y0sshi/RISC-V/boards/zybo_z720/vitis/README.md

# Zybo Z7-20 real-HW bring-up (Vitis / boot side)

Offline (no-board) preparation for booting the RISC-V SoC bitstream on real Zybo
Z7-20 hardware. The Vivado bitstream side is in `../vivado/`; this directory holds
the PS-side boot artifacts (XSA -> FSBL -> BOOT.bin) and the JTAG bring-up script.

All Xilinx tools must run from **PowerShell**, not Bash/MSYS (its path translation
crashes Vivado synth and the Vitis server). Find the tools via `$env:XILINX_VIVADO` /
`$env:XILINX_VITIS` (or PATH after `settings64.bat`); examples below run from the repo
root, where `$PWD\...` gives Vivado the absolute `-source` path it needs.

**One-shot (cross-platform):** `python boards/zybo_z720/build_all.py` (Windows or Linux,
stdlib only) runs `bit -> fsbl -> bootbin` (use `--stage xsa fsbl bootbin` to reuse an
existing impl).  Retarget the PL clock first with `python ..\set_pl_freq.py <MHz>`.  The
bash/docker side (firmware, sim, tests) is the top-level `make` -- run `make help` at the repo root.

## Clock / UART facts baked into the design (read first)

- PL clock `FCLK_CLK0` = **25 MHz** (`build_zybo.tcl` `PL_FREQMHZ=25`).
- `rv_soc` `MTIME_DIV=1` => CLINT `mtime` ticks at **25 MHz** on hardware.
- The 16550 bit period is `divisor*16` PL clocks; the 8250 driver programs
  `divisor = clock-frequency/(16*baud)`, so `actual_baud = PL/(divisor*16) =
  25e6*baud/clock-frequency`.

Therefore the **real-HW device tree** (`docs/opensbi/rv_soc_hw.dts`,
`tests/linux/rv_soc_linux_hw.dts`) differs from the sim DTS in three constants:

| DT property | sim (`*_lo.dts`) | real HW (`*_hw.dts`) | why |
|---|---|---|---|
| `timebase-frequency` | 1000000 | **25000000** | mtime really runs at 25 MHz (sim slows it via `BOOT_MTIME_DIV=64`); wrong value = 25x time error + HZ-tick livelock risk |
| serial `clock-frequency` | 1843200 | **25000000** | must equal the PL clock or the baud divisor is wrong |
| serial `current-speed` | 115200 | **57600** | 25 MHz can't make a clean 115200 (+/-4%); 57600 -> divisor 27 -> 57870 baud = +0.47% |

Use a **57600 8N1** terminal on hardware.

## prep-A/B/C (done offline)

- **prep-A** real-HW DTS: `docs/opensbi/rv_soc_hw.dts`, `tests/linux/rv_soc_linux_hw.dts`.
- **prep-B** export XSA from the built impl (no re-impl):
  ```
  & "$env:XILINX_VIVADO\bin\vivado.bat" -mode batch `
      -source $PWD\boards\zybo_z720\vivado\export_xsa.tcl `
      *> $PWD\boards\zybo_z720\vivado\export_xsa.log 2>&1
  ```
  -> `../vivado/rv_riscv_zybo/rv_riscv_zybo.xsa` (ps7_init + bitstream). The full
  `build_zybo.tcl bit` flow now also emits the XSA automatically.
- **prep-C** FSBL + BOOT.bin:
  ```
  & "$env:XILINX_VITIS\bin\vitis.bat" -s `
      $PWD\boards\zybo_z720\vitis\fsbl.py *> $PWD\boards\zybo_z720\vitis\fsbl.log 2>&1
  python make_bootbin.py --firmware <fw_payload_hw.bin>   # or .\make_bootbin.ps1 -Firmware ... ; default = sim fw_payload_lo.bin
  ```
  - FSBL is auto-generated by the standalone platform build ->
    `ws/zybo_plat/export/zybo_plat/sw/boot/fsbl.elf` (32-bit ARM, ps7_init).
  - `make_bootbin.ps1` writes `boot.gen.bif` (firmware **before** bitstream, raw
    `.bin` with `[load=0x00200000]` and no exec addr) and runs bootgen. Verified
    layout: FSBL(exec OCM) -> firmware@0x200000 (data, no A9 handoff) -> bitstream
    last, so the RISC-V core leaves reset with firmware already resident in DDR.

## prep-D/E (done offline) -- ready for the board

- **prep-E DONE** real-HW OpenSBI hello firmware is built and BOOT.bin is staged
  with it:
  - `tests/opensbi/work/fw_payload_hw.{elf,bin}` (entry 0x200000, 25 MHz/57600 DTB),
  - `BOOT.bin` regenerated via `make_bootbin.ps1 -Firmware ...fw_payload_hw.bin`.
  - Rebuild recipe (if the DTS changes):
    ```
    docker run --rm -v "E:/work/git/RISC-V.git:/workspace" -w /workspace/tests/opensbi \
      riscof_run:latest bash -c \
      "FW_BASE=0x00200000 DTS=/workspace/docs/opensbi/rv_soc_hw.dts OUT=fw_payload_hw bash build.sh"
    cp tests/opensbi/work/opensbi/build/platform/generic/firmware/fw_payload.elf \
       tests/opensbi/work/fw_payload_hw.elf
    .\make_bootbin.ps1 -Firmware ...\fw_payload_hw.bin
    ```
  - Linux later: `tests/linux/build.sh` with `DTS=.../rv_soc_linux_hw.dts
    OUT=fw_payload_linux_hw` (CRLF-strip per CLAUDE.md); swap the elf in
    `bringup_jtag.tcl`.
- **prep-D DONE** JTAG bring-up script `bringup_jtag.tcl` (XSDB debug flow, which IS
  available here -- only the classic IDE project flow is not). It `connect`s,
  selects the A9, runs `ps7_init`/`ps7_post_config`, `dow`s `fw_payload_hw.elf` to
  0x200000, then `fpga`-configures the PL so the RISC-V core boots from 0x200000.
  `ps7_init.tcl` is extracted from the XSA (gitignored; re-extract with
  `python -c "import zipfile; open('ps7_init.tcl','wb').write(zipfile.ZipFile(r'../vivado/rv_riscv_zybo/rv_riscv_zybo.xsa').read('ps7_init.tcl'))"`).

## On the board (P1 -- run these)

1. Power the Zybo, set JTAG boot mode (or insert the SD with `BOOT.bin` for SD boot).
2. Wire a 3.3 V USB-UART to **Pmod JC**: FPGA TX=**V15** -> adapter RX,
   FPGA RX=**W15** <- adapter TX, common GND. Open the terminal at **57600 8N1**.
3. JTAG path (recommended):
   ```
   & "$env:XILINX_VITIS\bin\xsct.bat" `
       $PWD\boards\zybo_z720\vitis\bringup_jtag.tcl
   ```
   Expect the OpenSBI banner + `PAYLOAD: hello` on the UART.
4. SD path (alternative): copy `BOOT.bin` to a FAT32 SD card, set SD boot mode,
   power-cycle.

## Artifacts (all gitignored)

- `ws/` Vitis workspace + FSBL, `../vivado/rv_riscv_zybo/rv_riscv_zybo.xsa`,
  `BOOT.bin`, `boot.gen.bif`, `*.log`.
