y0sshi/RISC-V/(commit log)

2026-06-04 UART 16550
2026-06-13 timing: cut worst-path fanout with max_fanout hints
2026-06-14 boards: build RV64 FPGA bitstream; fix BD module-ref + OOC XLEN define
    [rv_soc_wrap.v]
2026-06-14 fix: mal_state restart-livelock under ~imem_ready (RTL bug #15)
    The misaligned 2-phase access FSM reset mal_state to idle unconditionally once
    both word accesses finished, even when the instruction could not retire that
    cycle (EX held by ~imem_ready from an in-flight I$ fill / straddle bypass).
    That re-asserted mal_stall and restarted phase 0 -> permanent stall_if -> no
    interrupts -> livelock. Same restart class as amo_state / muldiv_done(#14) /
    fpu_done, but mal was the one unguarded FSM. Latent since before afe5f4a; the
    C-2a/C-2c multicycle work shifted pipeline timing enough to expose it (C-2b
    BRAM only changed where the kernel derailed).
    [rv_core.sv]
2026-06-14 fix: misaligned LOAD phase-0 word lost to flush_ex_mem on younger-instr trap (RTL bug #16)
    A misaligned 8-byte LOAD retiring from MEM had its mal FSM reset by the generic
    flush_ex_mem when a timer interrupt was taken on the YOUNGER EX-stage instruction,
    zeroing mal_first_data on its capture cycle (mal_phase1_start) so the load wrote
    back only its phase-1 half. Reset the mal FSM only on the access's own MEM fault
    (mal_squash = mem_trap_enter & ~stall_ex). Strict no-op except preserving the
    phase-0 word. Repro: src/software/boot/mal_load_irq_test.S.
    Regression: mal_load_irq_test PASS (old FAIL), mini-SBI IF=573 data=4 unchanged,
    RV64 117/RV32 88, full Linux LINUX-USERSPACE-OK, #14/#15/atomic/l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
    [rv_core.sv]
2026-06-15 boards: real-HW Zybo BD (PS7 board preset + UART Pmod pins + DDR RST_ADDR)
    Promote the headless Zybo bitstream to a board-bootable config: vendor the
    Digilent Zybo Z7-20 board files, apply the PS7 board preset and externalize
    FIXED_IO/DDR (FIXED_IO critical warnings 100->0), route UART to Pmod JC
    (V15/W15) via zybo_uart.xdc, and set RST_ADDR=0x0020_0000 so the firmware
    sits in the HP0-mapped PS DDR window. Timing closes at 25 MHz (WNS +0.377ns,
    0 failing EP). Sim unchanged (rv_soc default RST_ADDR=0x8000_0000).
    [muldiv_split_meas.sv, rv_soc_wrap.v, tb_rv_boot_soc.sv]
2026-06-16 boards: real-HW bring-up prep (real-HW DTS + XSA export + FSBL/BOOT.bin)
2026-06-16 boards: real-HW firmware (0x200000 DTS) + JTAG bring-up script
2026-06-16 build: unify entry points (top-level Makefile + FPGA build_all.ps1)
    Organize scattered commands into two families (hard constraint: Vivado/Vitis
    need PowerShell, so "all make" is impossible):
    - top-level Makefile: thin dispatcher for the bash/docker flows (deps/fw-*/
    boot-*/compliance/riscof/sim-* delegation). Quote $(MAKE) -- GnuWin32 make's
    spaced "(x86)" path breaks under MSYS /bin/sh otherwise.
    - boards/zybo_z720/build_all.ps1: one-shot bit -> fsbl -> bootbin.
    Dependency policy: keep riscv-tests/riscv-arch-test as submodules; OpenSBI/Linux/
    arch-test-suite stay pinned clones/tarballs (CRLF + size + docker-built), with
    `make deps` pinning OpenSBI v1.2.
2026-06-18 fix(icache): serve RVC line-crossing window as a 2-line hit, drop S_BYPASS
    The straddle (line-crossing) fetch window was served by a multi-cycle
    uncached bypass. When a branch/redirect targeted a straddle address whose
    second line was not yet cached, the bypass exposed a fetch/redirect squash
    race that livelocked OpenSBI (stuck at fdt_address_cells entry, 314 chars)
    and Linux. Replace the bypass with a 2-line cache supply: a second
    registered read port (line_q2, set idx+1) gives a 1-cycle hit when both
    adjacent lines are cached; a cold straddle fills the missing line(s) via
    the normal S_FILL/S_FILL2 path then hits. No uncached path remains, so
    every access is an aligned line burst (also fixe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
    [rv_icache.sv, tb_rv_icache.sv]
2026-06-18 refactor(boards): cross-platform Python FPGA build (build_all.py/make_bootbin.py)
2026-06-18 fix(soc): honor D$ wait during an instruction-fetch PTW (AMO write-loss)
    rv_soc's `core_dmem_wait = ptw_req ? 0 : dc_c_wait` blinded the core to an
    in-flight D-cache access for ANY ptw_req -- including an instruction-fetch
    page-table walk (ptw_for_if=1) that is independent of the held data access.
    When an amoadd.w's read phase took a D$ miss (multi-cycle line fill) and a
    concurrent IF-PTW fired during the fill, the mask dropped dmem_wait to 0, so
    amo_state advanced to its WRITE phase mid-fill (rv_core.sv:923); the AMO then
    retired at the S_RELOOKUP cycle (c_wait drops) before S_LOOKUP could latch the
    write -> the AMO write was LOST. atomic_dec_and_test on nl_table_users then
    left the counter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
    [rv_axi_dualport_mem_bfm.sv, rv_cpu.sv, rv_mmu.sv, rv_soc.sv, tb_rv_boot_soc.sv]
2026-06-19 perf(core/dcache): register D$ tag behind a per-access strobe + fix SRET-handoff deadlock (50MHz step 1)
    Two coupled changes toward raising the core from 25 to 50 MHz. The critical
    path is a single combinational chain
    ex_mem_alu_result -> data TLB -> D$ tag -> dmem_wait -> stall_if -> fetch -> I$
    (real ~38.5ns @25MHz, needs <=20ns).
    1) Register the D$ tag lookup so it no longer reaches c_wait in one cycle.
    A naive in-place 2-phase oscillated c_wait every cycle on a hit HELD in MEM
    by an unrelated stall -- the simple bus is level-req (no per-access strobe),
    so the D$ cannot tell a NEW access from a completed-but-held one; that
    corrupted atomics under full Linux. Instead rv_cor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
    [rv_core.sv, rv_cpu.sv, rv_dcache.sv, rv_soc.sv, tb_rv_boot_soc.sv, tb_rv_dcache.sv]
2026-06-20 perf(core/mmu): register the data-TLB MEM-port lookup off the stall_if path (50MHz step 2)
    Pass the per-access strobe into rv_mmu's MEM port and drive
    mem_pa/mem_req_out/mem_fault/mem_stall from a registered TLB lookup
    (vm_data-gated; bare/M-mode passthrough no-op). Removes the data TLB
    from the ex_mem_alu_result -> ... -> stall_if critical path (impl
    worst-path moves to the D$-load -> FPU-forward chain; WNS 0.370->1.130
    @25MHz). Fixes three variable-latency bugs the registration exposed:
    eviction-spurious-PTW store-loss (gate PTW launch by ~mem_reg_ready),
    stale mt_valid (clear on !mem_req), and the registered-mem_fault
    commit-gate deadlock (gate the trap redirect by ~stall_ex, same as the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
    [rv_core.sv, rv_cpu.sv, rv_mmu.sv, tb_rv_mmu.sv]
2026-06-20 perf(core/fetch): pipeline the fetch (decoupled FIFO + registered redirect) to take
    the data stall and the trap/branch redirect off the imem_addr -> IF-TLB -> I$ path
    (50MHz step 4, approach B)
    Decouple the fetch engine from decode with a 4-deep fetch FIFO (step 1) so the data
    stall reaches imem_addr only through the registered ff_count occupancy, and register
    the redirect steer (step 2) so the data-dependent combinational redir_req no longer
    fans out to imem_addr. Together imem_addr becomes fully register/I$-local driven,
    removing the ex_mem_alu_result -> dmem_wait/irq -> redir_req -> imem_addr -> IF-TLB
    -> I$ worst path. Cost: +4.5% boot cycles (FIFO) + a +1-cycle taken-redirect
    penalty;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
    [rv_core.sv]
2026-06-21 Fix/Refactor: Bump CPU clock frequency from 25MHz to 30MHz
    [rv_core.sv, rv_fpu.sv, rv_muldiv.sv, tb_rv_fpu.sv, tb_rv_mext.sv]
2026-06-21 perf(fpga): bump CPU clock 30->40MHz (RTL unchanged; fetch loop is not the binding path)
    Real-impl measurement under a tight clock constraint overturns the
    sessions-14..16 conclusion that the IF fetch-translation loop is the 50MHz
    binding path and that a decoupled block-fetch rewrite (case A) is the only
    way to 20ns. That conclusion was an artifact of the slack 33ns constraint:
    Vivado relaxes placement once timing is met, inflating the fetch loop to
    ~29.5ns and making it look like the binding path.
    Probing the synth checkpoint at a 20ns constraint (build_physopt.tcl, both
    default and aggressive strategies) shows the placer/router pushes the fetch
    loop under ~21ns, and the new binding path be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
2026-06-22 perf(core/fpu): register the FP-adder operands to break the EX-forward->sum_q path (50MHz step 7)
    The post-step6 50MHz binding was the FP adder sum_q stage-0
    (ex_mem_rd_addr -> FP forward select -> fpld load forward -> adder
    operand -> align/exp-subtract -> mantissa-add CARRY4 -> sum_q, ~21.4ns
    @20ns probe). Mirror step 5 (misc): the four adders now read REGISTERED
    operands instead of the live EX forward mux output -- u_add fa_s_q/fb_s_q,
    u_add_d fa_q/fb_q (existing), u_fma_add fc_s_q, u_fma_add_d fc_q (new
    free-running fc register) -- cutting the forward-mux + fpld routing off
    the front of the adder stage-0 cloud.
    Latency-neutral (COMB_LAT unchanged, rv_core unchanged): FADD lands at
    T+2,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
    [rv_fpu.sv]
2026-06-25 fix(icache): serve a completed fill before the resume-prime advances addr_q (step8 fetch-skip)
    step8's FTQ presents the next address while the current word is still being
    filled. If that next address takes an IF-TLB-miss PTW, the MMU withdraws
    c_req mid-fill (req_q drops), so the completed fill is never served; the
    resume-prime then overwrites addr_q with the next address, SKIPPING the
    filled word and mis-tagging the next word with the skipped PC (aligner
    PC/data desync) -> wrong decode -> NULL-deref in full Linux NET=y (~65M cyc).
    Add a fill_unserved latch (set on S_FILL m_done, cleared on c_ready) that
    gates the resume-prime so a completed-but-unserved fill is served first.
    No EXTRA-2 rein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
    [rv_core.sv, rv_cpu.sv, rv_icache.sv, tb_rv_axi_core.sv, tb_rv_axi_ifetch.sv, tb_rv_boot_soc.sv]
2026-06-25 perf(fpu): pipeline rv_fpu_misc_d into 2 stages to break the FCVT D-stage path (50MHz step 9)
    The default-strategy 50MHz binding was the FCVT.D.W / FCVT.W.D second-stage
    combinational tail in rv_fpu_misc_d (operand reg -> compute -> result reg, one
    ~20ns arc, route ~66%). Split it with one internal free-running register: stage 1
    does the FCVT.D.W normalize/shift, the cheap ops, the FCVT.W.D special-case
    detect, and FCVT.S.D/D.S; stage 2 does FCVT.D.W rounding, the FCVT.W.D in-range
    shift+round+sign, and the output mux. The two heavy barrel shifts land in
    separate stages.
    Latency-neutral: COMB_LAT stays 2. The old misc path had one cycle of capture
    slack (result valid T+2, captured T+3); the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
    [rv_fpu.sv, rv_fpu_misc_d.sv]
2026-06-25 perf(core): interlock integer load->branch + read branch operands from registers (50MHz step 10)
    The default-strategy 50MHz binding path was the load->branch->flush loop:
    D$ BRAM load -> load shaping -> MEM/WB forward -> branch compare -> branch_taken
    -> redirect/flush -> id_ex clock-enable, a single combinational cycle.
    Mirror the existing FP-load fpld technique for the integer branch path:
    - rv_hazard: stall a conditional branch one extra cycle while an integer load it
    depends on is in MEM, so the branch reaches EX only after the load retires and
    its value is captured into id_ex via the regfile write bypass (registered).
    - rv_core: feed u_branch's comparison operands from br_rs*_data,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
    [rv_core.sv, rv_hazard.sv]
2026-06-25 build(fpga): split build_zybo into project/synth/impl/bit stages, drop create_project -force
    Project creation is now its own idempotent stage; synth/impl/bit open the existing
    project and resume (reset-if-stale), so no stage recreates the project and there is
    no -force. impl stops after route_design (reports routed WNS); bit writes the
    bitstream + XSA. build_all.py --stage gains synth/impl/bit/fpga for resuming from an
    intermediate point (e.g. --stage impl bit, or --stage bit alone). Removes the
    stopgap impl_only.tcl.
2026-06-25 perf(fpu): pipeline rv_fpu_add_d into 3 stages for real 50MHz margin (step 11)
    step10 closed default-flow 50MHz at only +0.042 ns, which booted in sim but
    crashed on real silicon (kdevtmpfs/filename_create NULL deref = compute
    corruption from too-thin setup margin; 40MHz ran reliably at +0.172 ns). The
    entire near-worst cluster (top 40 routed paths) was the FPU result network; the
    worst was the double-precision adder, both its align+add (-> sum_q) and its
    normalize/round + output mux (-> ex_mem_fpu_result_f) arcs at ~19.6-19.9 ns.
    Split rv_fpu_add_d from 2 into 3 register stages:
    stage 0: extract/classify/swap/align -> registered aligned operands
    stage 1: 57-bit significand add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
    [rv_fpu.sv, rv_fpu_add_d.sv]
2026-06-27 fix(core): gate FTQ head pop on reload-settle re-serve (step8 fetch skid)
    The redirect-reload settle presents the target for an extra cycle (redir_pend_q
    hold + the ftq[0] reload both drive imem_addr=target), so the I$ serves it once
    more than it is pushed. ftq_pop lacked the ~hb_dup gate that hb_push has, so the
    FTQ head advanced one word ahead of the served/pushed stream; a later full-buffer
    hold release then skipped a served-but-unpushed word, tagging the next word with
    the stale bfpc -> a 4-byte fetch skid. On full Linux this made path_parentat
    execute `sd zero,0(s2)` instead of `sd a5,8(s3)`, leaving parent->dentry NULL ->
    filename_create NULL deref (the Zybo step8 hardware crash; rep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
    [rv_core.sv]
2026-06-27 test(boot-sim): RANDLAT BFM + RANDLAT-immune fetch/mem detectors for step8 debug
    Debug infrastructure that reproduced and root-caused the step8 fetch-skid crash
    (see fix "gate FTQ head pop on reload-settle re-serve"):
    - rv_axi_dualport_mem_bfm: per-channel variable latency (BFM_RANDLAT / BFM_SEED /
    BFM_RAND_SPREAD). Independent LFSR streams de-phase the IF/data/write ports so
    the I$-fill-vs-PTW interleave the bug needs is exercised; deterministic per seed.
    The fixed-latency default phase-locks the ports and hides it.
    - tb_rv_boot_soc detectors (under BOOT_TRACE):
    - [STDROP]/[STCORRUPT]: RANDLAT-immune store/AMO write-to-DRAM matcher -- enqueue
    each committed DRAM write at the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
    [rv_axi_dualport_mem_bfm.sv, tb_rv_boot_soc.sv]
2026-06-29 fix(core): IF page-fault saves the mid-word target PC, not its word
    An instruction page fault captured the WORD-aligned fetch address
    (imem_addr = redirect target & ~3) as the faulting PC. For a redirect
    target that is 2-byte aligned (PC % 4 == 2 -- e.g. a compiled userspace ELF
    entry such as musl's 0x101be), the demand-page handler then returned 2 bytes
    early, to target & ~3 (0x101bc), and executed the low halfword (c.ebreak)
    instead of the entry -> SIGTRAP -> init killed -> kernel panic (exitcode=5).
    The hand-written static init.c (4-byte-aligned entry) and the M/S-mode
    kernel never hit this, so it was masked until a real compiled userspace
    binary (Buildroot busybox/bash) ran.
    Fix: when t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
    [rv_core.sv]
2026-07-02 fix(core): #17 fetch/PTW livelock on demand-paged CALL target IF page fault
    A JAL to an unmapped .text page (musl busybox memset) page-faulted on its
    redirect target; the faulting fetch never raised imem_ready, so the full
    pipeline freeze held the JAL in EX (redir_eff stuck high), the ifpf trap
    could never latch/take, and the MMU walked the dead VA forever (PC frozen,
    zero retires). Add fetch_dead_q to drain in-flight instructions past a
    page-faulted fetch, tighten the ifpf-take gate to all-bubble, and stop the
    dead-IF walk from starving a data PTW / mis-attributing a zombie fault.
    No-op unless an instruction fetch page-faults (fetch_dead_q === 0 in bare/
    M-mode/all compliance). Repro: src/s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
    [rv_core.sv, rv_mmu.sv, tb_rv_boot_soc.sv]
2026-07-02 build(linux): rootfs-in fw + sim boot entry points (fw-linux-rootfs, boot-linux-rootfs)
    Wire the Buildroot rootfs (bash) flow into the top-level Makefile so the
    "build rootfs-in Linux fw -> boot in sim / stage for real HW" path is
    discoverable from `make help` and reachable in a few targets.
    - fw-linux-rootfs / fw-linux-rootfs-hw: thin wrappers that build the
    Buildroot rootfs then wrap it into the Linux fw_payload. The
    ROOTFS=buildroot target-specific variable is inherited by the
    rootfs-buildroot + fw-linux[-hw] prerequisites (no re-implementation).
    - boot-linux-rootfs: delegate to src/sim vl_boot on the 0x80000000-base
    fw_payload_linux.hex (MEM_BASE default -> no BOOT_MEM_BASE), wit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
2026-07-03 fix(core): faulting load/store spuriously retires garbage register write
    MEM/WB wasn't gated by mem_trap_enter (a page-fault on the load/store
    currently in EX/MEM): the faulting access itself advanced to WB one cycle
    later and wrote whatever garbage dmem_rdata the invalid access produced
    into its destination register. Any load reusing its base register as the
    destination (the extremely common `lw a4,0(a4)` / `lbu a1,0(a1)`
    pointer-chase idiom) got corrupted whenever the address was unmapped --
    found via Linux userspace (busybox) segfaulting on stale/garbage
    addresses after real page faults, reached now that the rootfs boots to a
    real bash shell (ROOTFS-BASH-OK).
    Fix: add mem_trap_enter to th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
    [rv_core.sv, tb_rv_boot_soc.sv]
2026-07-03 docs: post-RootFS review — ROADMAP refresh, freq_50mhz summary, TB knob map, vivado script README
2026-07-03 build: Linux host support for docker toolchain (exec bits + UID mapping)
    Set +x on all tracked .sh scripts in the git index so Linux checkouts
    get them automatically (Windows core.fileMode=false hides the bit).
    Add a DOCKER_USER var (--user $(id -u):$(id -g) -e HOME=/tmp) to every
    docker run invocation across the top-level and src/sim, src/software,
    tests/compliance, tests/riscof Makefiles, gated on OS!=Windows_NT, so
    containers no longer leave root-owned artifacts on native Linux bind
    mounts. Windows Docker Desktop already maps ownership, so DOCKER_USER
    expands empty there and every docker command is byte-identical
    (verified via dry-run + a live sim_alu run). rootfs-buildroot also
    chowns th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
2026-07-04 fix(linux): make the serial getty shell a real login shell
    busybox getty's `-l /bin/bash` execs bash with argv[0] left as the plain
    path (no leading '-') and no --login flag, so bash never recognizes
    itself as a login shell and silently skips /etc/profile. Wrap it with
    /sbin/login_bash (exec /bin/bash --login) so /etc/profile always runs.
    Also add /etc/profile: a raw UART serial console (no pty) never receives
    a TIOCSWINSZ from the terminal client, so the kernel's winsize stays
    0x0. This alone is benign, but busybox vi's fallback path for a failed
    winsize query sends a cursor-position request (ESC[6n) and misparses
    the trailing 'R' of the terminal's reply as a vi command, silently
    dropping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
2026-07-04 build(boards): add PYNQ-Z1/Z2 Vivado/Vitis build scripts
    Port the Zybo Z7-20 build flow (build_all.py, set_pl_freq.py,
    build_<board>.tcl, export_xsa.tcl, rv_soc_wrap.v, UART XDC, and the
    Vitis bring-up scripts) to PYNQ-Z1 and PYNQ-Z2, which share the same
    XC7Z020 chip. Board files are vendored from the community
    xupsh/pynq-supported-board-file repo (Digilent's own vivado-boards
    repo doesn't carry PYNQ). board_part is resolved at runtime via
    get_board_parts instead of hardcoded, since PYNQ-Z1's board.xml uses
    an older mixed-case vendor string unlike Zybo/PYNQ-Z2's lowercase
    convention. UART is wired to Pmod JB (JB1/JB2) since neither PYNQ
    board exposes a Pmod JC like Zybo.
    Validated by runnin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
    [rv_soc_wrap.v]
2026-07-04 build(boards): add production Vivado/Vitis flow for Kria KV260
    Rewrite the 207-line build_kv260.tcl placeholder (unconditional
    -force recreate, no board_part, UART tied to a constant) into a
    stage-separated build (project/synth/impl/bit, matching Zybo/PYNQ)
    using the Vivado-bundled kv260_som board_part for DDR4 bring-up, and
    add build_all.py, set_pl_freq.py, export_xsa.tcl, kv260_uart.xdc, and
    Vitis-side fsbl.py/bringup_jtag.tcl.
    Validated the Vivado 'project' stage (BD generation only, no synth):
    board_part resolves, apply_board_preset configures DDR4 at 64-bit
    width with zero critical warnings. UART is wired to the J2 Pmod-
    compatible header (som240_1_b21/b22, package pins E12/D11), cross-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
    [rv_soc_wrap.v]
2026-07-05 fix(boards/kv260): fix JTAG bring-up on real hardware, add xmutil load path
    Iteratively fix bringup_jtag.tcl against real KV260 hardware output.
    The board's carrier card has no boot-mode switch at all (factory-
    locked to QSPI32), so every power-on auto-boots QSPI->U-Boot->Linux
    before JTAG even attaches; add a `boot_jtag` step (AMD's own reference
    procedure: multiboot register clear, boot-mode override, full system
    reset) to force a clean JTAG-wait state instead. Also fix: select a
    target before `fpga -file` (fails "No supported FPGA device found"
    otherwise), unlock the PMU MicroBlaze's debug-visibility security gate
    with a settling delay before selecting it (a bare selection right
    after the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
